DPTPSystem/WaterBottleCap/(list of files, cad)

Other CAD files:
P12F683/kupak.obj
P12F683/startup.obj
